soggybag/GlitchStorm-v3/archive/v3.0/parts.csv

Reference | Value | Footprint | Side | X mm | Y mm | Rotation | LCSC | Fitted by
A1 | Arduino Nano | Module:Arduino_Nano | front | 139.49 | 66.39 | -90.0 |  | hand
C1 | 100n | Capacitor_SMD:C_0805_2012Metric_Pad1.18x1.45mm_HandSolder | front | 107.75 | 85.0 | 0.0 | C49678 | JLC
C2 | 100n | Capacitor_SMD:C_0805_2012Metric_Pad1.18x1.45mm_HandSolder | front | 111.25 | 85.5 | 90.0 | C49678 | JLC
C3 | 100n | Capacitor_SMD:C_0805_2012Metric_Pad1.18x1.45mm_HandSolder | front | 114.75 | 85.0 | 0.0 | C49678 | JLC
C4 | 100n | Capacitor_SMD:C_0805_2012Metric_Pad1.18x1.45mm_HandSolder | front | 119.0 | 84.75 | 0.0 | C49678 | JLC
C5 | 10n | Capacitor_SMD:C_0805_2012Metric_Pad1.18x1.45mm_HandSolder | front | 155.43 | 89.0 | 0.0 | C1710 | JLC
C6 | 1n | Capacitor_SMD:C_0805_2012Metric_Pad1.18x1.45mm_HandSolder | front | 171.25 | 89.75 | 0.0 | C46653 | JLC
C7 | 10u | Capacitor_SMD:C_0805_2012Metric_Pad1.18x1.45mm_HandSolder | front | 157.5 | 109.25 | 90.0 | C15850 | JLC
C8 | 1u | Capacitor_SMD:C_0805_2012Metric_Pad1.18x1.45mm_HandSolder | front | 149.25 | 116.25 | 0.0 | C28323 | JLC
C9 | 10u | Capacitor_SMD:C_0805_2012Metric_Pad1.18x1.45mm_HandSolder | front | 181.25 | 94.0 | 90.0 | C15850 | JLC
C10 | 10u | Capacitor_SMD:C_0805_2012Metric_Pad1.18x1.45mm_HandSolder | front | 153.5 | 115.25 | 0.0 | C15850 | JLC
C11 | 1u | Capacitor_SMD:C_0805_2012Metric_Pad1.18x1.45mm_HandSolder | front | 180.5 | 97.25 | 0.0 | C28323 | JLC
C12 | 22u | Capacitor_SMD:C_1206_3216Metric_Pad1.33x1.80mm_HandSolder | front | 165.25 | 98.25 | 90.0 | C12891 | JLC
C13 | 100n | Capacitor_SMD:C_0805_2012Metric_Pad1.18x1.45mm_HandSolder | front | 161.75 | 98.25 | 0.0 | C49678 | JLC
C14 | 10u | Capacitor_SMD:C_0805_2012Metric_Pad1.18x1.45mm_HandSolder | front | 164.25 | 93.25 | 90.0 | C15850 | JLC
C15 | 47n | Capacitor_SMD:C_0805_2012Metric_Pad1.18x1.45mm_HandSolder | front | 157.75 | 114.75 | 0.0 | C53134 | JLC
C16 | 220u | Capacitor_THT:CP_Radial_D6.3mm_P2.50mm | front | 150.0 | 129.5 | 0.0 |  | hand
C17 | 22u | Capacitor_SMD:C_1206_3216Metric_Pad1.33x1.80mm_HandSolder | front | 149.0 | 103.25 | 0.0 | C12891 | JLC
C18 | 22u | Capacitor_SMD:C_1206_3216Metric_Pad1.33x1.80mm_HandSolder | front | 144.0 | 111.75 | 90.0 | C12891 | JLC
C19 | 100n | Capacitor_SMD:C_0805_2012Metric_Pad1.18x1.45mm_HandSolder | front | 178.25 | 89.75 | 0.0 | C49678 | JLC
D1 | LED | LED_THT:LED_D3.0mm | back | 160.73 | 108.0 | 0.0 |  | hand
D2 | LED | LED_THT:LED_D3.0mm | back | 152.73 | 108.0 | 0.0 |  | hand
D3 | LED | LED_THT:LED_D3.0mm | back | 144.73 | 108.0 | 0.0 |  | hand
D4 | LED | LED_THT:LED_D3.0mm | back | 136.73 | 108.0 | 0.0 |  | hand
D5 | SS14 | Diode_SMD:D_SMA_Handsoldering | front | 184.5 | 82.0 | 90.0 | C2480 | JLC
H1 | MountingHole_3.2mm_M3 | MountingHole_3.2mm_M3 | front | 104.0 | 90.0 | 0.0 |  | hand
H2 | MountingHole_3.2mm_M3 | MountingHole_3.2mm_M3 | front | 193.0 | 90.0 | 0.0 |  | hand
H3 | MountingHole_3.2mm_M3 | MountingHole_3.2mm_M3 | front | 103.75 | 126.0 | 0.0 |  | hand
H4 | MountingHole_3.2mm_M3 | MountingHole_3.2mm_M3 | front | 193.0 | 126.0 | 0.0 |  | hand
J1 | PHONES | SuperFreq:Jack_3.5mm_PJ-320A_Horizontal | front | 157.0 | 58.95 | 0.0 |  | hand
J2 | LINE OUT | SuperFreq:Jack_3.5mm_PJ-320A_Horizontal | front | 171.0 | 58.95 | 0.0 |  | hand
J3 | DC 9V | Connector_BarrelJack:BarrelJack_Horizontal | front | 185.25 | 72.7 | -90.0 |  | hand
R1 | 1k | Resistor_SMD:R_0805_2012Metric_Pad1.20x1.40mm_HandSolder | front | 169.5 | 110.75 | 0.0 | C17513 | JLC
R2 | 1k | Resistor_SMD:R_0805_2012Metric_Pad1.20x1.40mm_HandSolder | front | 161.5 | 110.75 | 0.0 | C17513 | JLC
R3 | 1k | Resistor_SMD:R_0805_2012Metric_Pad1.20x1.40mm_HandSolder | front | 137.5 | 110.75 | 0.0 | C17513 | JLC
R4 | 1k | Resistor_SMD:R_0805_2012Metric_Pad1.20x1.40mm_HandSolder | front | 129.5 | 110.75 | 0.0 | C17513 | JLC
R5 | 1k | Resistor_SMD:R_0805_2012Metric_Pad1.20x1.40mm_HandSolder | front | 139.5 | 84.75 | 0.0 | C17513 | JLC
R6 | 10k | Resistor_SMD:R_0805_2012Metric_Pad1.20x1.40mm_HandSolder | front | 170.75 | 93.25 | 90.0 | C17414 | JLC
R7 | 100k | Resistor_SMD:R_0805_2012Metric_Pad1.20x1.40mm_HandSolder | front | 164.25 | 105.25 | 0.0 | C17407 | JLC
R8 | 470 | Resistor_SMD:R_0805_2012Metric_Pad1.20x1.40mm_HandSolder | front | 174.0 | 80.5 | 0.0 | C17710 | JLC
R9 | 100k | Resistor_SMD:R_0805_2012Metric_Pad1.20x1.40mm_HandSolder | front | 177.0 | 86.75 | 0.0 | C17407 | JLC
R10 | 100k | Resistor_SMD:R_0805_2012Metric_Pad1.20x1.40mm_HandSolder | front | 146.75 | 111.25 | 90.0 | C17407 | JLC
R11 | 100k | Resistor_SMD:R_0805_2012Metric_Pad1.20x1.40mm_HandSolder | front | 150.75 | 112.5 | 0.0 | C17407 | JLC
R12 | 47k | Resistor_SMD:R_0805_2012Metric_Pad1.20x1.40mm_HandSolder | front | 169.0 | 96.5 | 0.0 | C17713 | JLC
R13 | 2k2 | Resistor_SMD:R_0805_2012Metric_Pad1.20x1.40mm_HandSolder | front | 166.75 | 93.25 | 90.0 | C17520 | JLC
R14 | 10 | Resistor_SMD:R_0805_2012Metric_Pad1.20x1.40mm_HandSolder | front | 156.0 | 112.25 | 0.0 | C17415 | JLC
R15 | 10 | Resistor_SMD:R_0805_2012Metric_Pad1.20x1.40mm_HandSolder | front | 153.25 | 97.25 | 180.0 | C17415 | JLC
R16 | 10 | Resistor_SMD:R_0805_2012Metric_Pad1.20x1.40mm_HandSolder | front | 157.25 | 98.5 | 0.0 | C17415 | JLC
R17 | 4R7 | Resistor_SMD:R_0805_2012Metric_Pad1.20x1.40mm_HandSolder | front | 150.0 | 110.0 | 0.0 | C17675 | JLC
RV1 | B10k | Potentiometer_THT:Potentiometer_Alpha_RD901F-40-00D_Single_Vertical | back | 182.5 | 99.5 | 90.0 |  | hand
RV2 | B10k | Potentiometer_THT:Potentiometer_Alpha_RD901F-40-00D_Single_Vertical | back | 152.5 | 99.5 | 90.0 |  | hand
RV3 | B10k | Potentiometer_THT:Potentiometer_Alpha_RD901F-40-00D_Single_Vertical | back | 122.5 | 99.5 | 90.0 |  | hand
RV4 | B10k | Potentiometer_THT:Potentiometer_Alpha_RD901F-40-00D_Single_Vertical | back | 182.5 | 129.5 | 90.0 |  | hand
RV5 | A10k | Potentiometer_THT:Potentiometer_Alpha_RD901F-40-00D_Single_Vertical | back | 122.5 | 129.5 | 90.0 |  | hand
SW1 | TSL-A064 | SuperFreq:SW_Push_Round_D12mm_P5.00mm_DAIER_TSL-A064 | back | 150.0 | 122.0 | 0.0 |  | hand
SW2 | TSL-A064 | SuperFreq:SW_Push_Round_D12mm_P5.00mm_DAIER_TSL-A064 | back | 135.0 | 122.0 | 0.0 |  | hand
SW3 | TSL-A064 | SuperFreq:SW_Push_Round_D12mm_P5.00mm_DAIER_TSL-A064 | back | 165.0 | 122.0 | 0.0 |  | hand
U2 | MCP6002 | Package_SO:SOIC-8_3.9x4.9mm_P1.27mm | front | 172.5 | 100.25 | 0.0 | C7377 | JLC
U3 | LM386 | Package_SO:SOIC-8_3.9x4.9mm_P1.27mm | front | 160.25 | 93.25 | 90.0 | C23573 | JLC
