soggybag/GlitchStorm-v3/3dmodels/SW_Push_Round_D12mm_DAIER_TSL-A064.step

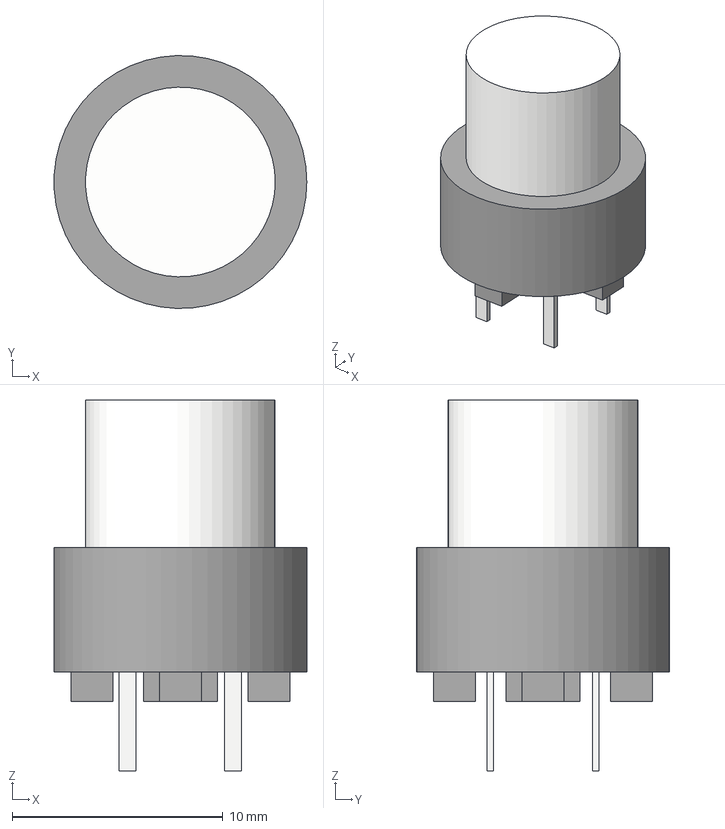
[picture p1: CAD file, 2026-10-07]
3dmodels/SW_Push_Round_D12mm_DAIER_TSL-A064.step
12.0 x 12.0 x 17.6 mm
cap
pins
