soggybag/GlitchStorm-v3/GlitchStorm3.pdf

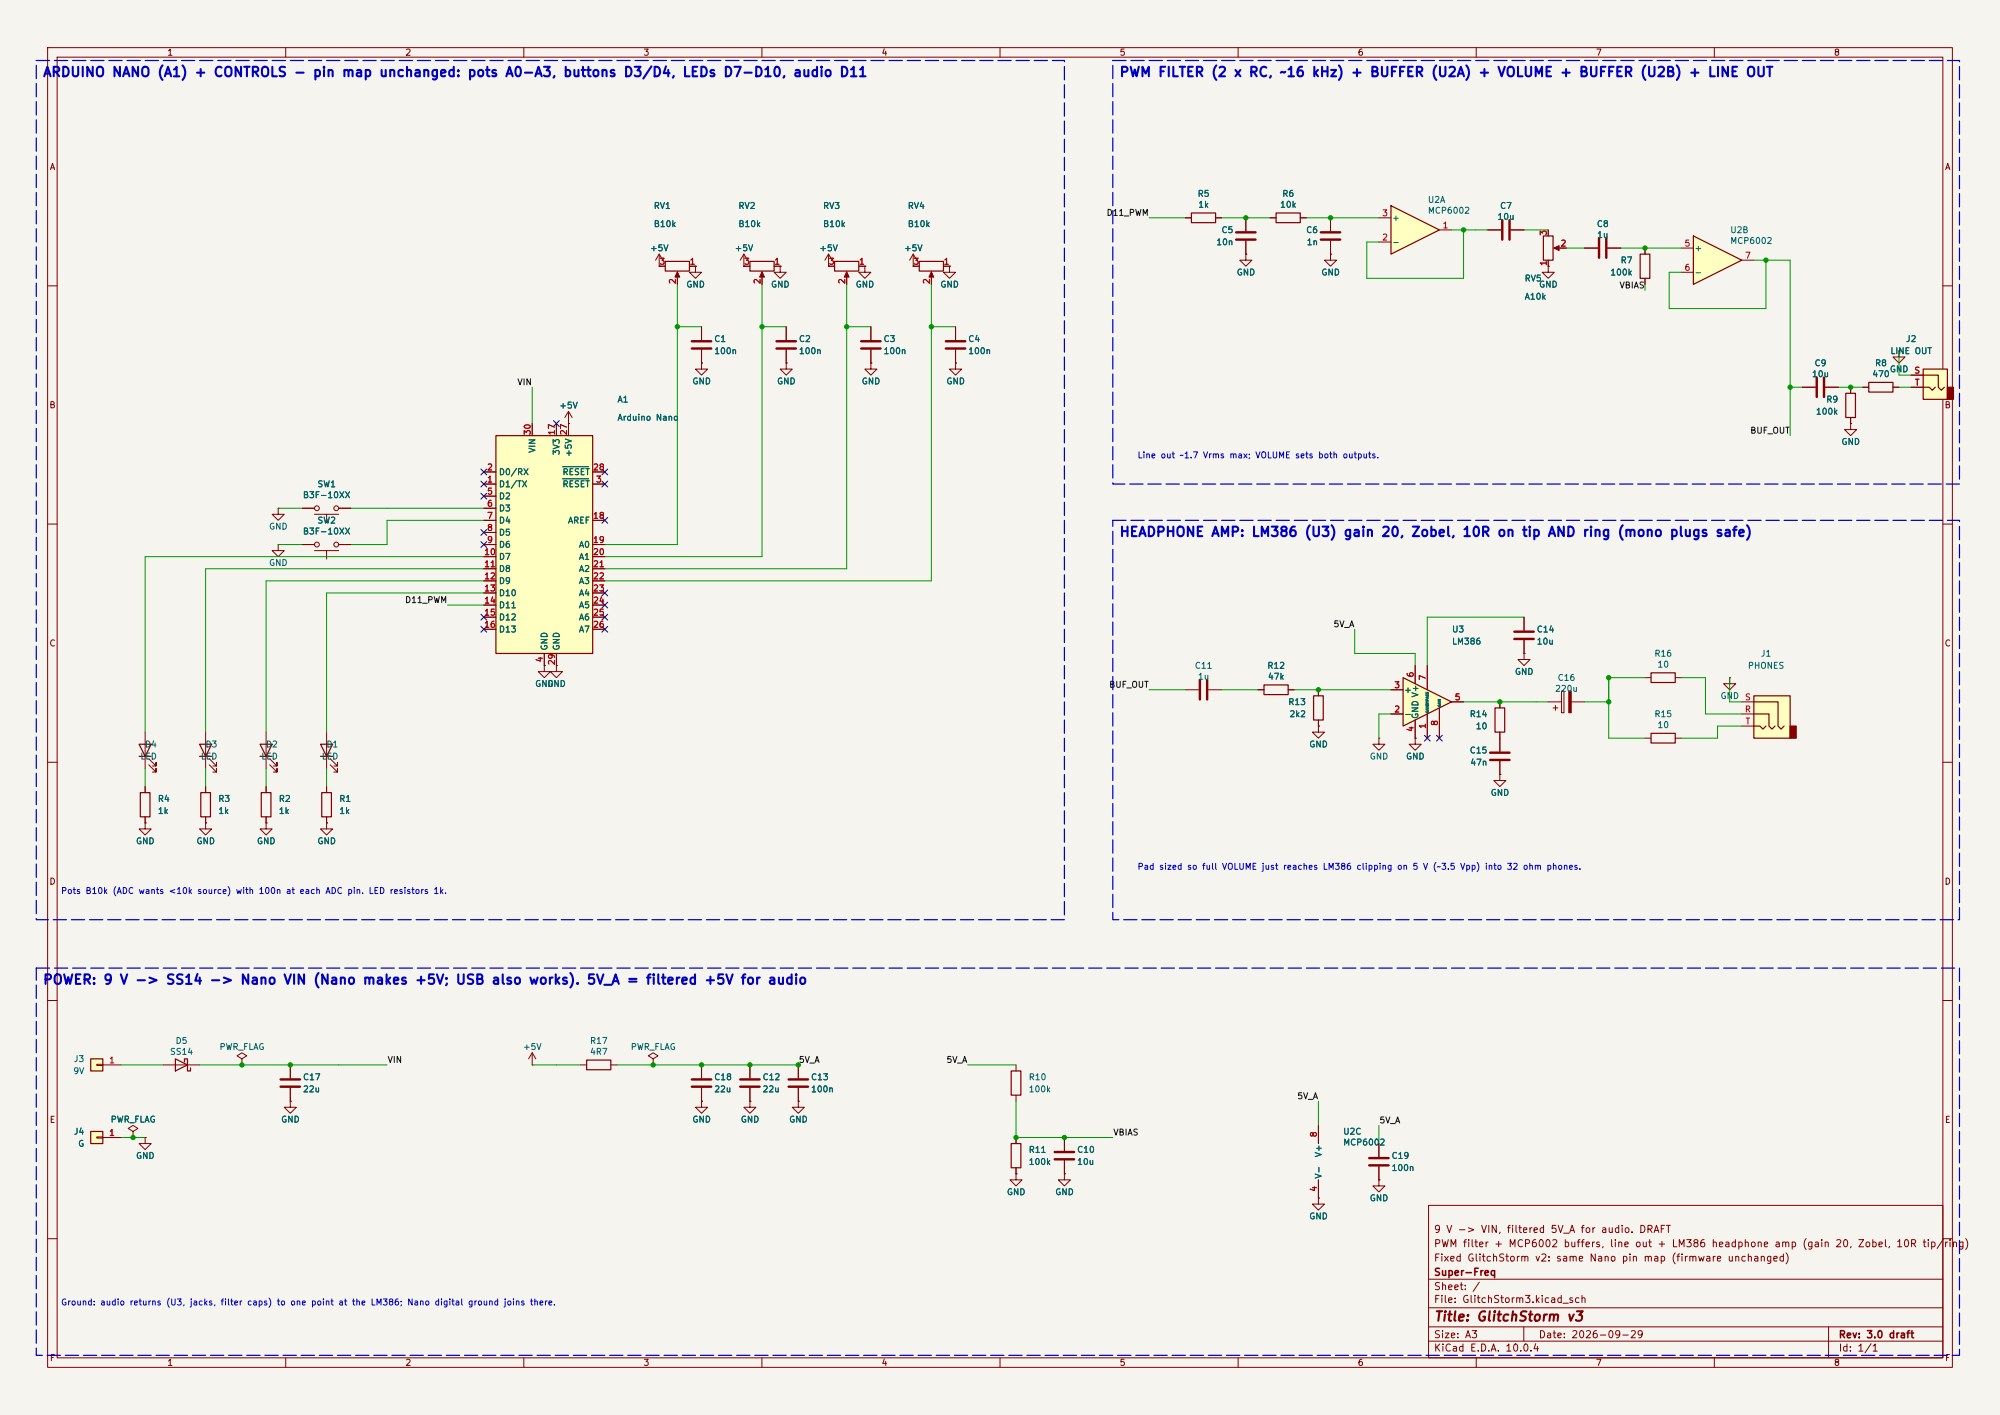
[picture p2: page 1]

ARDUINO NANO (A1) + CONTROLS - pin map unchanged: pots A0-A3, buttons D3/D4, LEDs D7-D10, audio D11

PWM FILTER (2 x RC, ~16 kHz) + BUFFER (U2A) + VOLUME + BUFFER (U2B) + LINE OUT

Line out ~1.7 Vrms max; VOLUME sets both outputs.

9 V -> VIN, filtered 5V_A for audio. DRAFT GND

PWM filter + MCP6002 buffers, line out + LM386 headphone amp (gain 20, Zobel, 10R tip/ring)
Fixed GlitchStorm v2: same Nano pin map (firmware unchanged)
Super-Freq
Sheet: /
File: GlitchStorm3.kicad_sch
Title: GlitchStorm v3

Size: A3 | Rev: 3.0 draft
KiCad E.D.A. 10.0.4 | Id: 1/1 | F Date: 2026-09-29
