soggybag/GlitchStorm-v3/archive/v3.0/GlitchStorm3_board_back.pdf

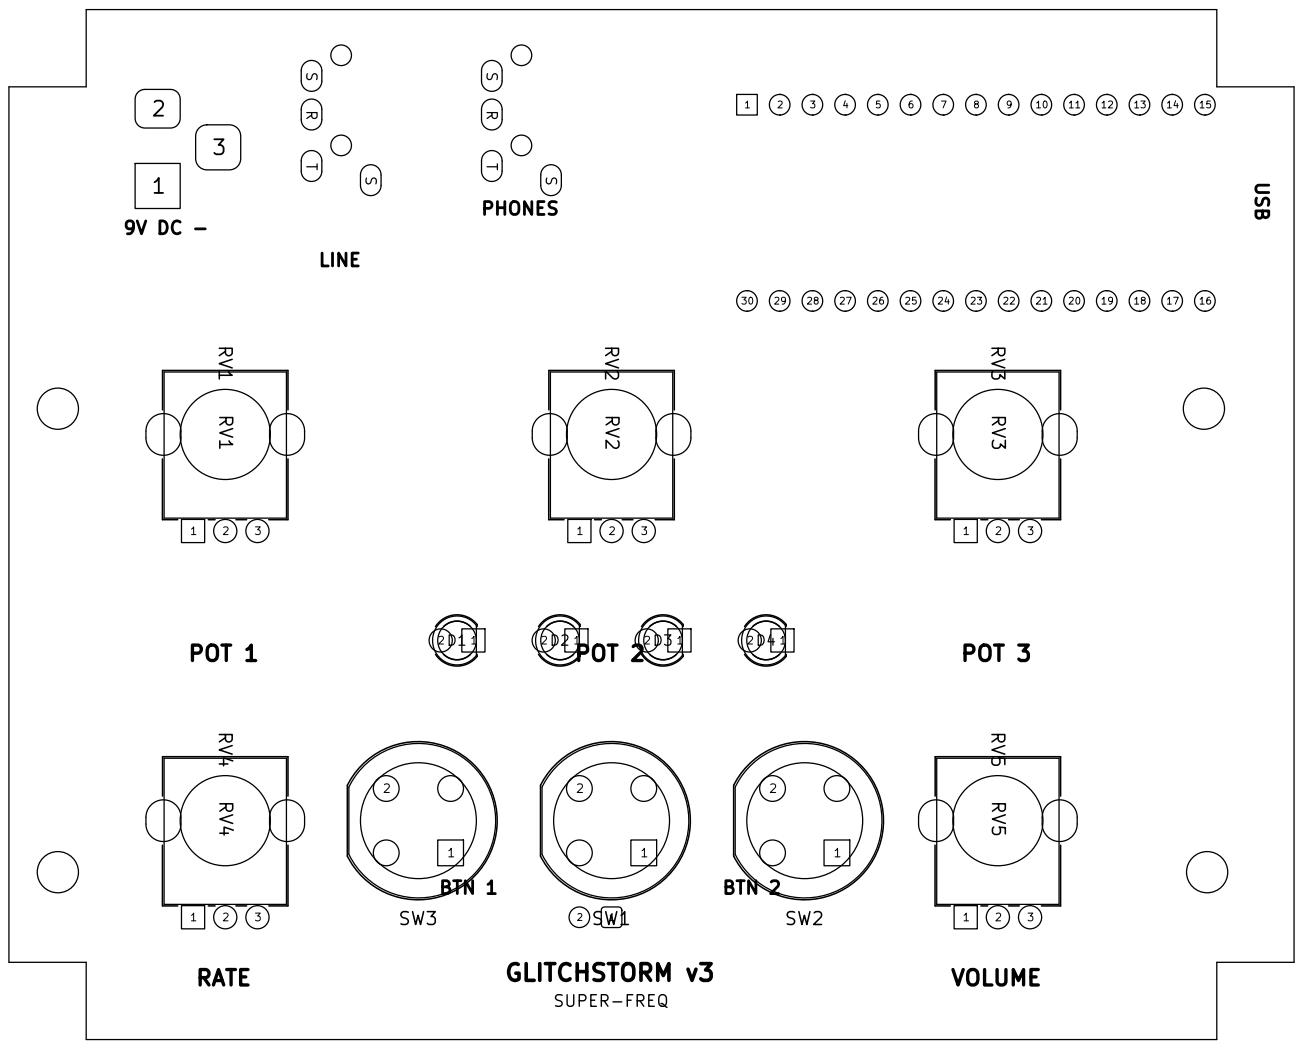
[picture p3: page 1]

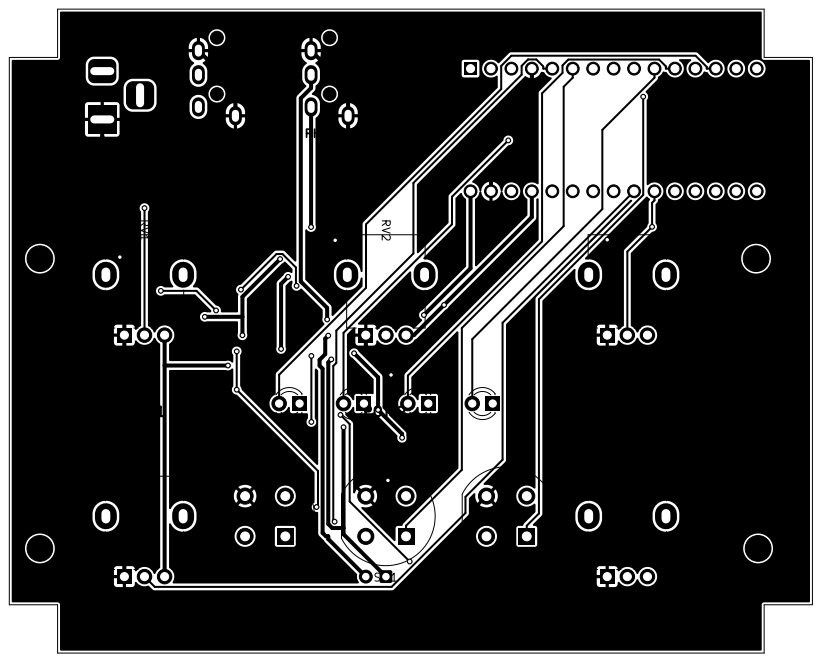
[picture p4: page 2]
