soggybag/GlitchStorm-v3/archive/v3.0/GlitchStorm3_board_front.pdf

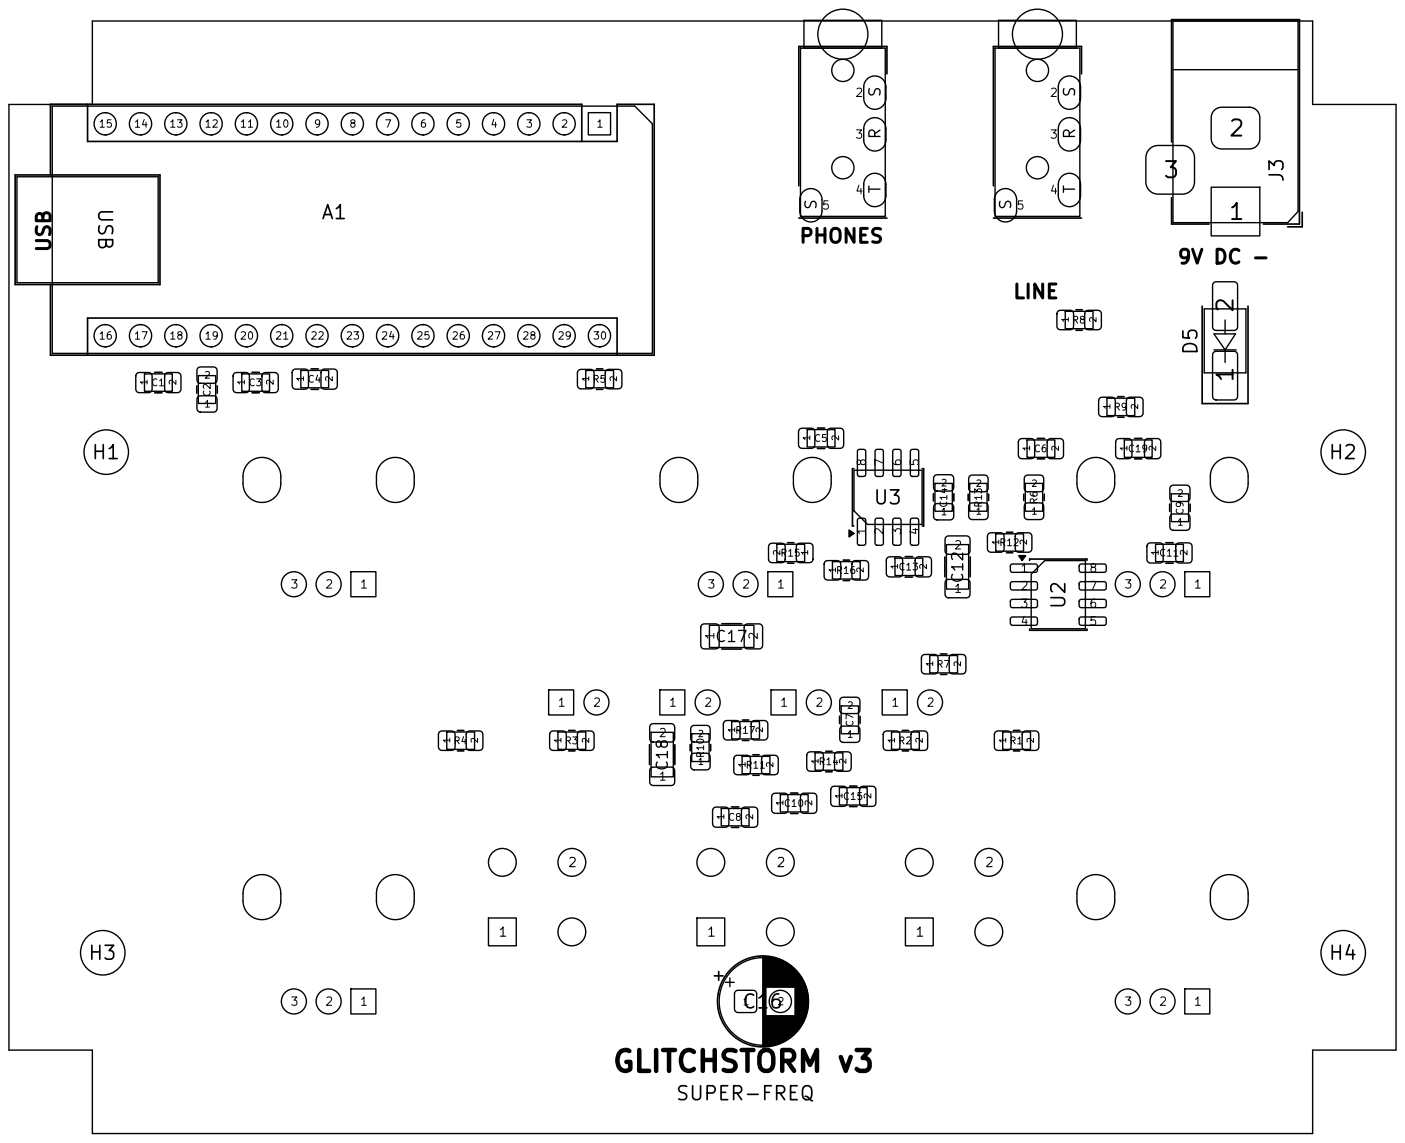
[picture p5: page 1]

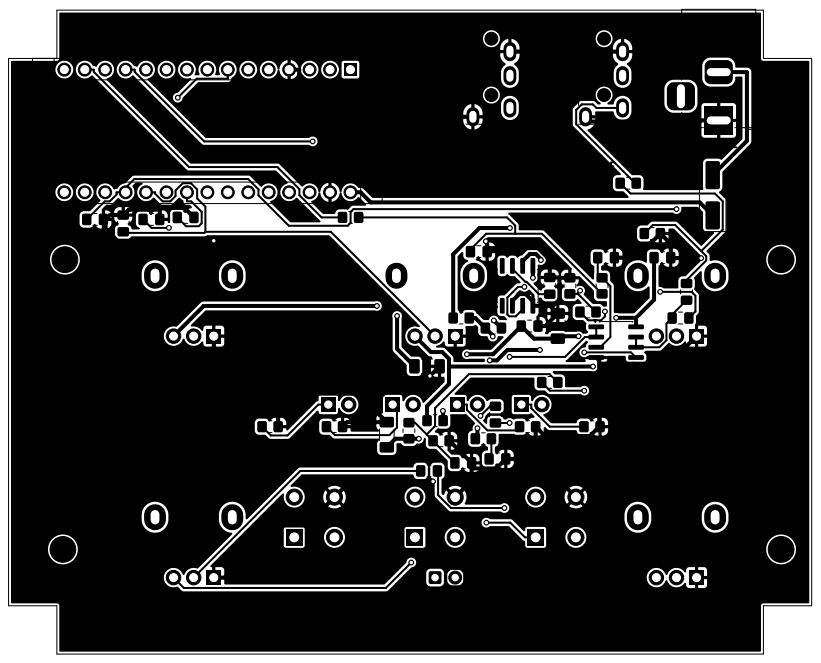
[picture p6: page 2]
