soggybag/GlitchStorm-v3/GlitchStorm3.kicad_pcb

## KiCad design GlitchStorm3.kicad_pcb (2026-10-11)

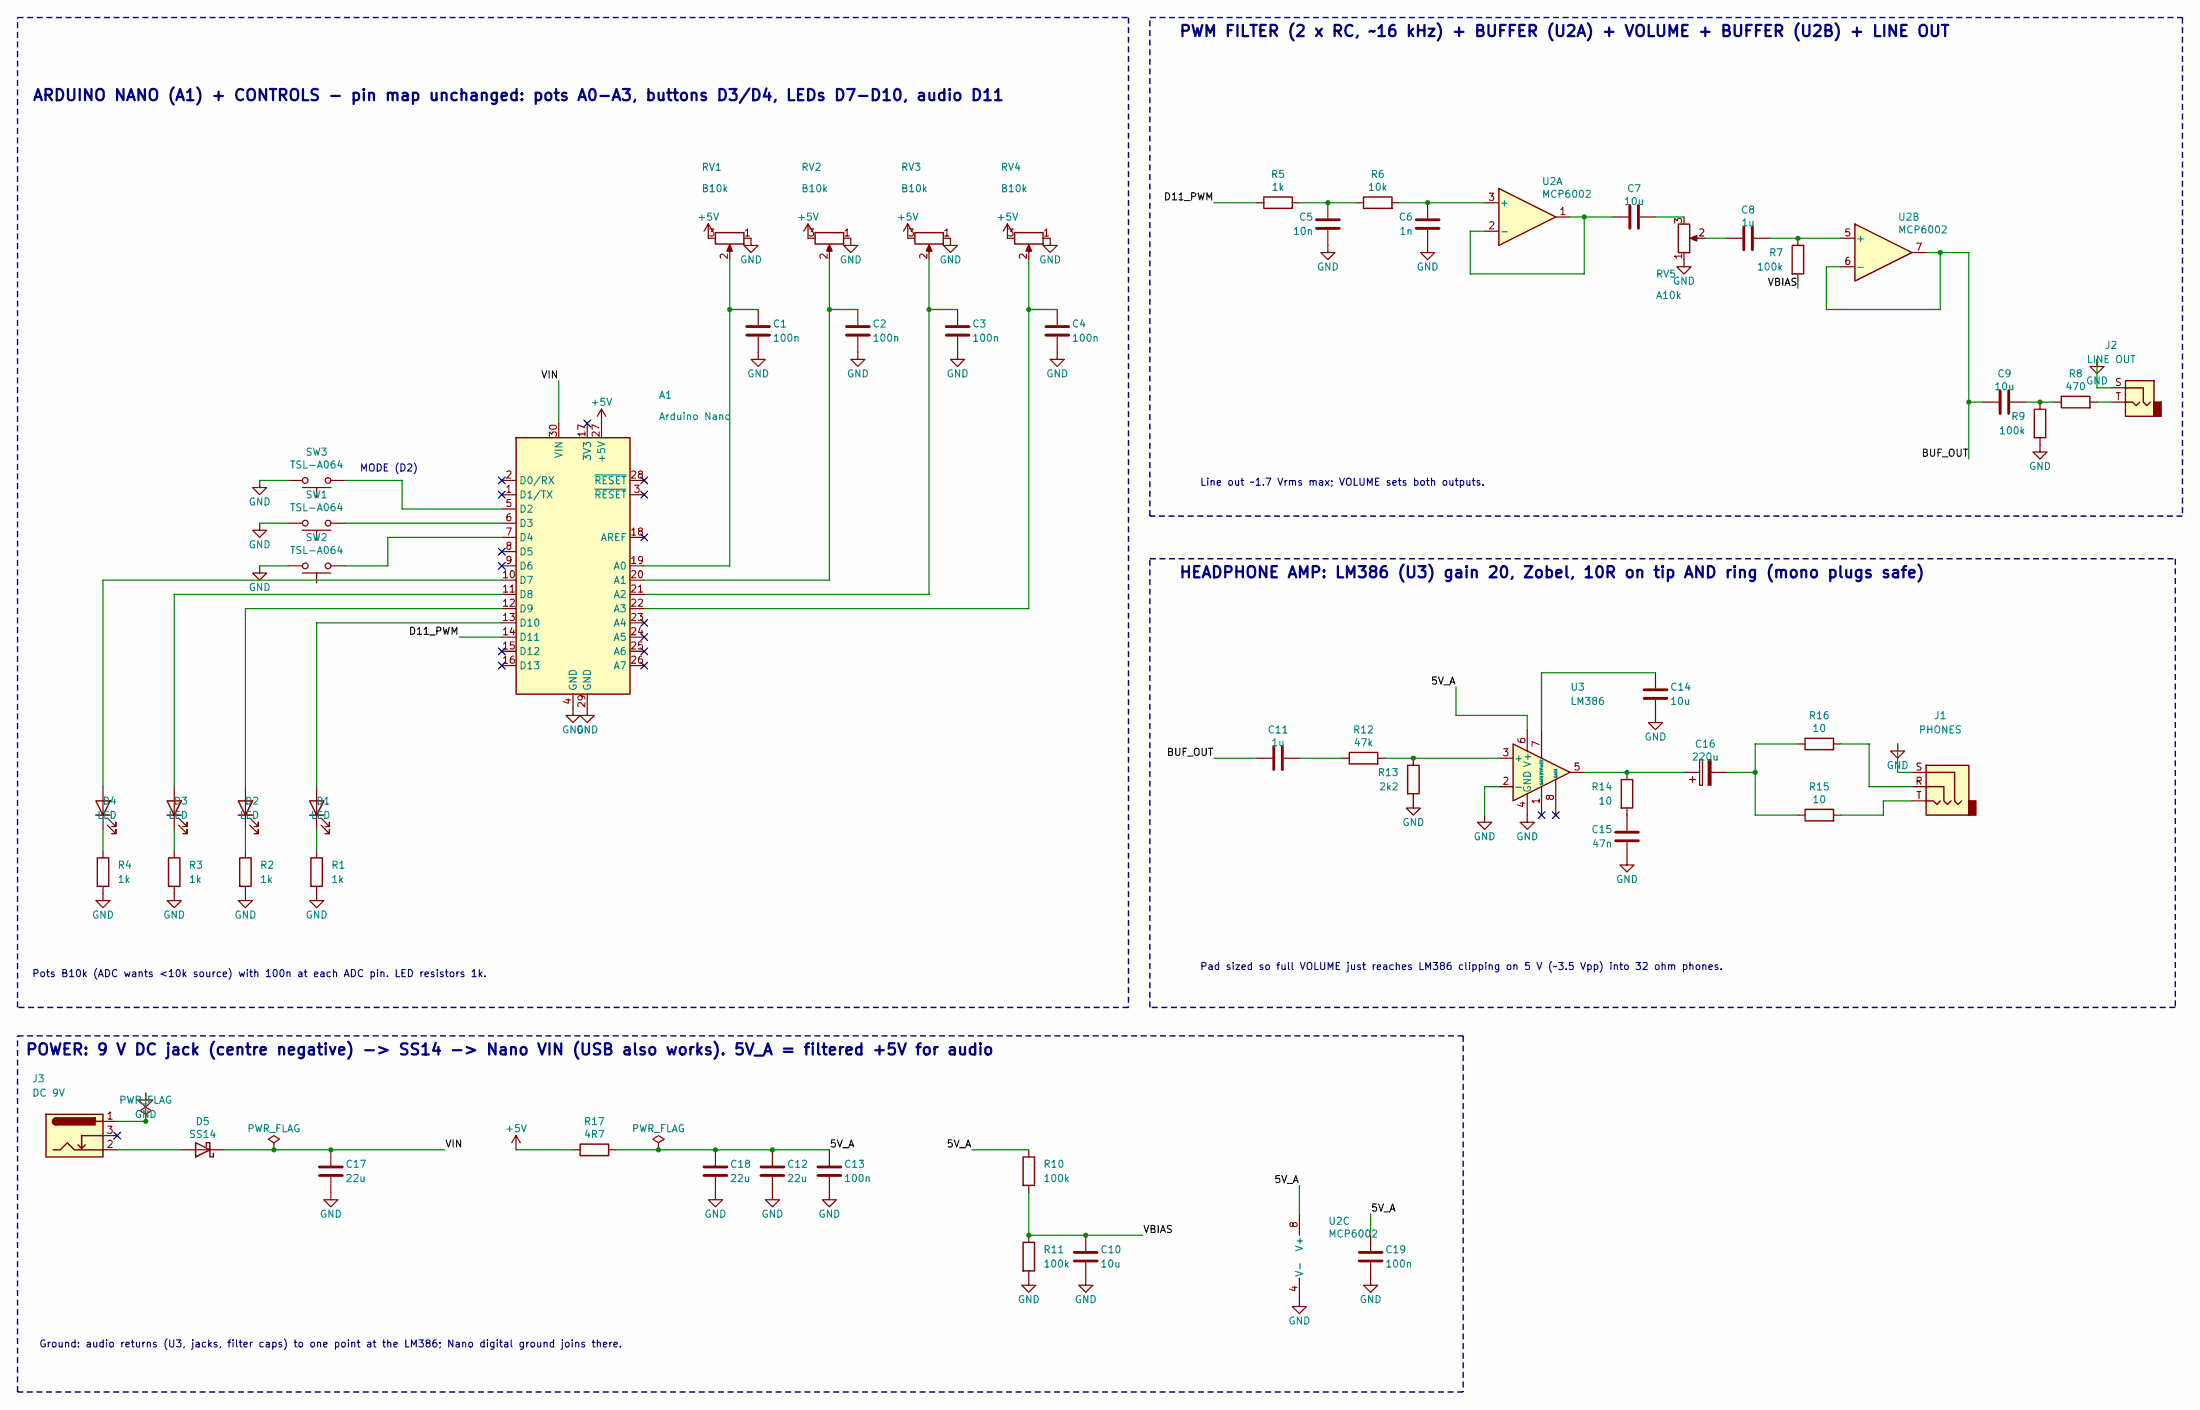
[picture p7: schematic GlitchStorm3.kicad_sch, GlitchStorm v3]

Parts:
A1: Arduino Nano; Arduino_Nano
C1, C2, C3, C4, C13, C19: 100n; C_0805_2012Metric_Pad1.18x1.45mm_HandSolder; LCSC C49678
C5: 10n; C_0805_2012Metric_Pad1.18x1.45mm_HandSolder; LCSC C1710
C6: 1n; C_0805_2012Metric_Pad1.18x1.45mm_HandSolder; LCSC C46653
C7, C9, C10, C14: 10u; C_0805_2012Metric_Pad1.18x1.45mm_HandSolder; LCSC C15850
C8, C11: 1u; C_0805_2012Metric_Pad1.18x1.45mm_HandSolder; LCSC C28323
C12, C17, C18: 22u; C_1206_3216Metric_Pad1.33x1.80mm_HandSolder; LCSC C12891
C15: 47n; C_0805_2012Metric_Pad1.18x1.45mm_HandSolder; LCSC C53134
C16: 220u; CP_Radial_D6.3mm_P2.50mm
D1, D2, D3, D4: LED; LED_D3.0mm
D5: SS14; D_SMA_Handsoldering; LCSC C2480
J1: PHONES; Jack_3.5mm_PJ-320A_Horizontal
J2: LINE OUT; Jack_3.5mm_PJ-320A_Horizontal
J3: DC 9V; BarrelJack_Horizontal
R1, R2, R3, R4, R5: 1k; R_0805_2012Metric_Pad1.20x1.40mm_HandSolder; LCSC C17513
R6: 10k; R_0805_2012Metric_Pad1.20x1.40mm_HandSolder; LCSC C17414
R7, R9, R10, R11: 100k; R_0805_2012Metric_Pad1.20x1.40mm_HandSolder; LCSC C17407
R8: 470; R_0805_2012Metric_Pad1.20x1.40mm_HandSolder; LCSC C17710
R12: 47k; R_0805_2012Metric_Pad1.20x1.40mm_HandSolder; LCSC C17713
R13: 2k2; R_0805_2012Metric_Pad1.20x1.40mm_HandSolder; LCSC C17520
R14, R15, R16: 10; R_0805_2012Metric_Pad1.20x1.40mm_HandSolder; LCSC C17415
R17: 4R7; R_0805_2012Metric_Pad1.20x1.40mm_HandSolder; LCSC C17675
RV1, RV2, RV3, RV4: B10k; Potentiometer_Alpha_RD901F-40-00D_Single_Vertical
RV5: A10k; Potentiometer_Alpha_RD901F-40-00D_Single_Vertical
SW1, SW2, SW3: TSL-A064; SW_Push_Round_D12mm_P5.00mm_DAIER_TSL-A064
U2: MCP6002; SOIC-8_3.9x4.9mm_P1.27mm; LCSC C7377
U3: LM386; SOIC-8_3.9x4.9mm_P1.27mm; LCSC C23573

Connections:
+5V: A1.27 (+5V), R17.1, RV1.3, RV2.3, RV3.3, RV4.3
/BUF_OUT: C9.1, C11.1, U2.6 (-), U2.7
/D11_PWM: A1.14 (D11), R5.1
/VBIAS: C10.1, R7.2, R10.2, R11.1
unnamed: A1.19 (A0), C1.1, RV1.2
unnamed: A1.20 (A1), C2.1, RV2.2
unnamed: A1.21 (A2), C3.1, RV3.2
unnamed: A1.22 (A3), C4.1, RV4.2
unnamed: A1.5 (D2), SW3.1
unnamed: A1.6 (D3), SW1.1
unnamed: A1.7 (D4), SW2.1
unnamed: A1.10 (D7), D4.2 (A)
unnamed: A1.11 (D8), D3.2 (A)
unnamed: A1.12 (D9), D2.2 (A)
unnamed: A1.13 (D10), D1.2 (A)
unnamed: C5.1, R5.2, R6.1
unnamed: C7.2, RV5.3
unnamed: C8.1, RV5.2
unnamed: C9.2, R8.1, R9.1
unnamed: C11.2, R12.1
unnamed: C15.1, R14.2
unnamed: C16.1, R14.1, U3.5
unnamed: C16.2, R15.1, R16.1
unnamed: D1.1 (K), R1.1
unnamed: D2.1 (K), R2.1
unnamed: D3.1 (K), R3.1
unnamed: D4.1 (K), R4.1
unnamed: D5.2 (A), J3.2
unnamed: J1.R, R16.2
unnamed: J1.T, R15.2
unnamed: J2.T, R8.2
unnamed: C6.1, R6.2, U2.3 (+)
unnamed: C7.1, U2.1, U2.2 (-)
unnamed: C8.2, R7.1, U2.5 (+)
unnamed: R12.2, R13.1, U3.3 (+)
unnamed: C14.1, U3.7 (BYPASS)

Notes on the sheet:
Pots B10k (ADC wants <10k source) with 100n at each ADC pin. LED resistors 1k.
Line out ~1.7 Vrms max; VOLUME sets both outputs.
ARDUINO NANO (A1) + CONTROLS - pin map unchanged: pots A0-A3, buttons D3/D4, LEDs D7-D10, audio D11
MODE (D2)
Ground: audio returns (U3, jacks, filter caps) to one point at the LM386; Nano digital ground joins there.
HEADPHONE AMP: LM386 (U3) gain 20, Zobel, 10R on tip AND ring (mono plugs safe)
PWM FILTER (2 x RC, ~16 kHz) + BUFFER (U2A) + VOLUME + BUFFER (U2B) + LINE OUT
POWER: 9 V DC jack (centre negative) -> SS14 -> Nano VIN (USB also works). 5V_A = filtered +5V for audio
Pad sized so full VOLUME just reaches LM386 clipping on 5 V (~3.5 Vpp) into 32 ohm phones.

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
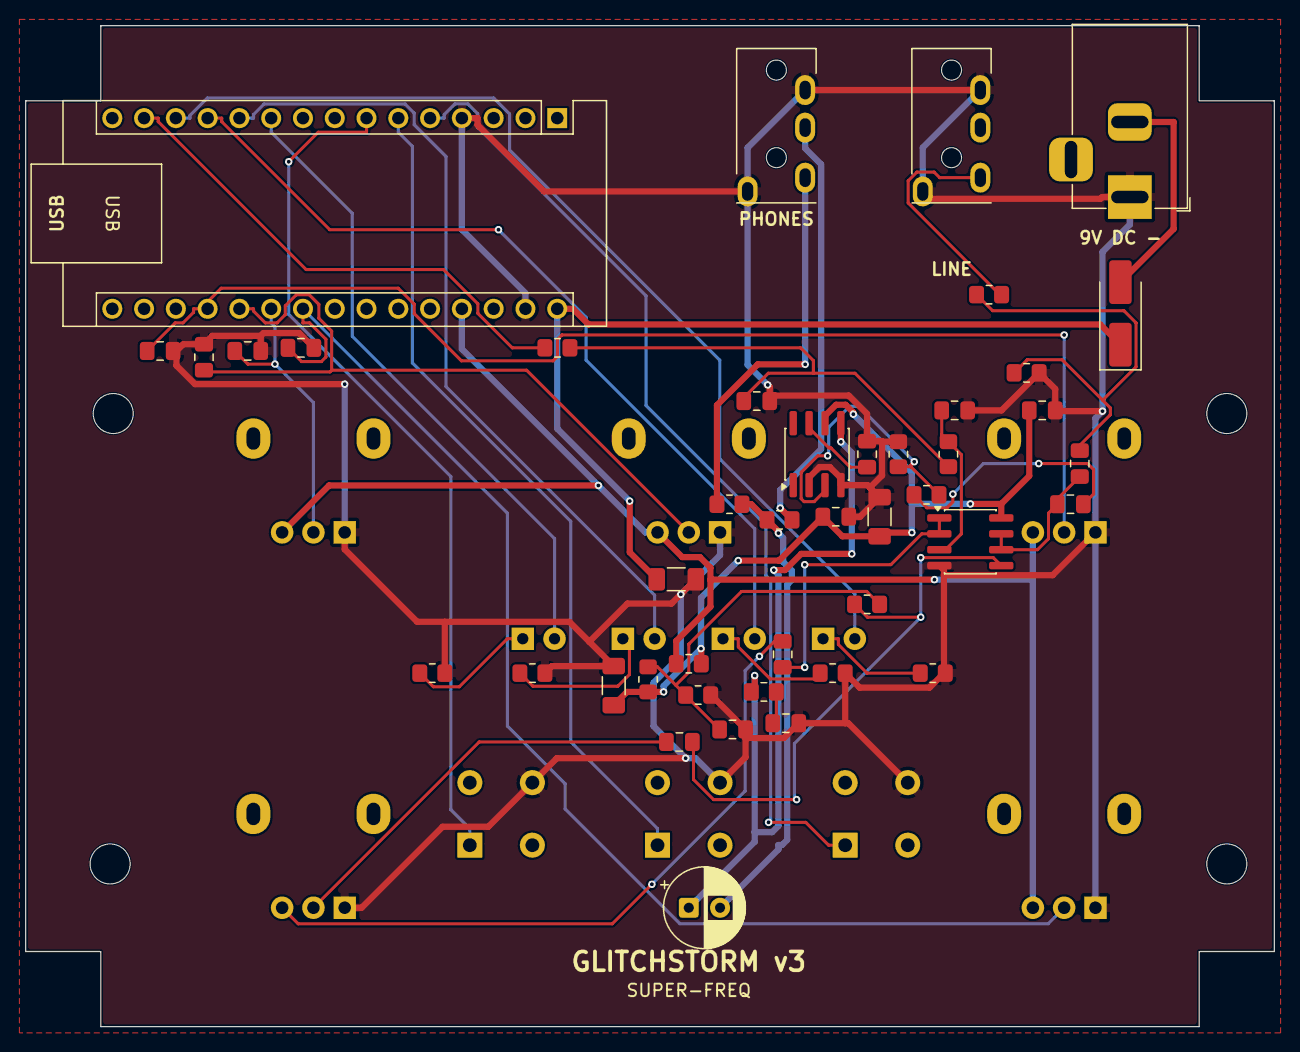
[picture p8: board GlitchStorm3.kicad_pcb from above]

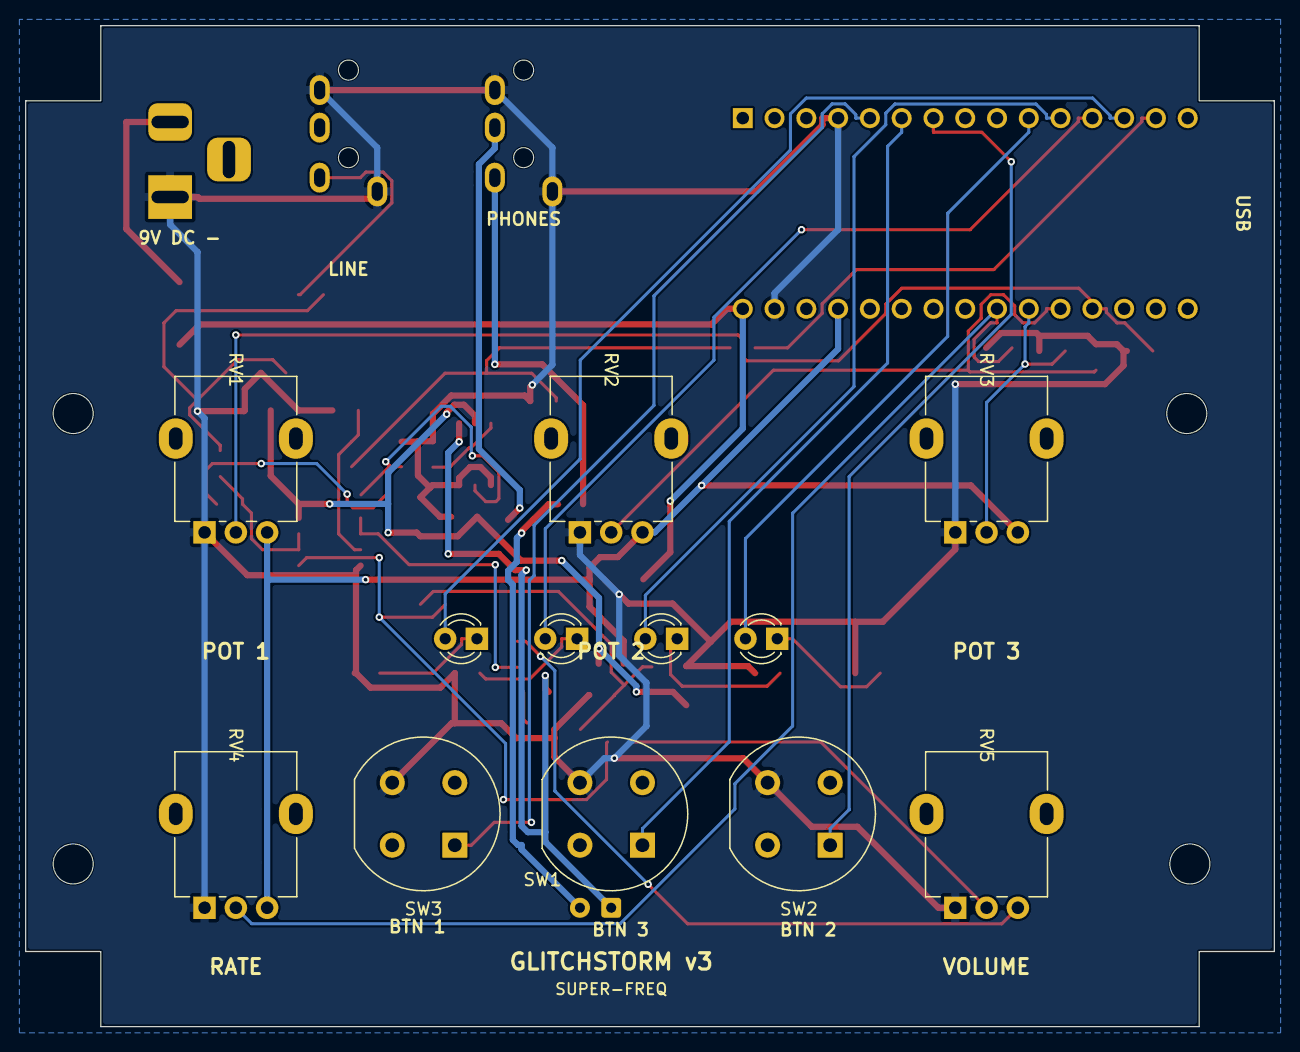
[picture p9: board GlitchStorm3.kicad_pcb from below]

Board: 2 copper layers, 99.8 x 80.0 mm, 60 parts (12 on the bottom side), 39 nets.

Other parts of the board:
ENC1: Hammond_1590BB
H1, H2, H3, H4: MountingHole_3.2mm_M3
