soggybag/GlitchStorm-v3/(commit log)

2026-10-07 GlitchStorm v3.0: SMD rebuild, 9 mm pots, MODE button, PJ-320A jacks, Tayda DC jack, 1590BB drilling
    As ordered from JLCPCB (October 2026 batch); the button 3D model and drill template were added after ordering (no fab changes).
2026-10-07 Archive v3.0: schematic and board PDFs, renders, interactive BOM, parts list, docs and fab files
2026-10-10 New PCB SMD
2026-10-11 GlitchStorm v3: bench test results, button relabel, mill marks, test sketch fixes
    - docs: Test Procedure v3.0 filled in through section 5 (power, rails, bias,
    controls, audio) with notes; Build Notes: measured heights (button cap ~2 mm
    proud, no taller button needed) and the v3.1 change list
    - board: button silkscreen BTN 1 / BTN 3 / BTN 2 (left to right); the centre
    button (BTN 3, D3) is MODE in the current firmware; user label moves
    - enclosure: Othermill marking SVG (1590BB face, hole outlines + 1 mm centre
    marks), checked against the v3.0 board; README mill notes
    - firmware/GS3_HWTest: MODE on the centre button (D3); double ADC reads and
    tone() hysteresis (fixes unstable low no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
2026-10-12 GlitchStorm v3: synth firmware port, bench fixes, test notes
    - firmware/GlitchStorm_v3: Glitch Storm (Synth/glitch-storm, Apr 2026) ported
    to the v3 board: BTN 1 (D2) up, BTN 3 (D3, centre) MODE = restart t,
    BTN 2 (D4) down; equations.h unchanged
    - fixes: buttons on a pin-change interrupt (polling missed presses at high
    RATE), per-equation CPU guard in the audio ISR (heavy equations 2-9 overran
    the sample period and froze the controls), up-button wrap off-by-one,
    double ADC reads, RATE hysteresis with a safe OCR1A update, Serial off
    - firmware/README.md: controls, changes, build notes; tested on the v3.0 board
    - docs: test procedure synth-firmware notes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
2026-10-12 GlitchStorm v3: Mozzi FM synth port, firmware README
    - firmware/FM_Synth_v3: the Mozzi FM synth (super-freq.com/arduino-fm-synth)
    ported to the v3 board: Mozzi 2 external-timed output to Timer 2 PWM on D11
    (D9/D10 are LEDs on v3); POT 1-3 + RATE = knobs 0-3; BTN 1 / BTN 2 = FM
    depth multiplier (old knob 4, shown on the LEDs); BTN 3 = modulation ratio
    1-8. Tested on the v3.0 board.
    - firmware/README.md: FM synth controls and notes; MODE on the Glitch Storm
    firmware stays as restart (t = 0)
